oskarvh/wasp/hardware/wasp_node_board/wasp_node_board.kicad_pcb

## KiCad design hardware/wasp_node_board/wasp_node_board.kicad_pcb (2026-09-20)

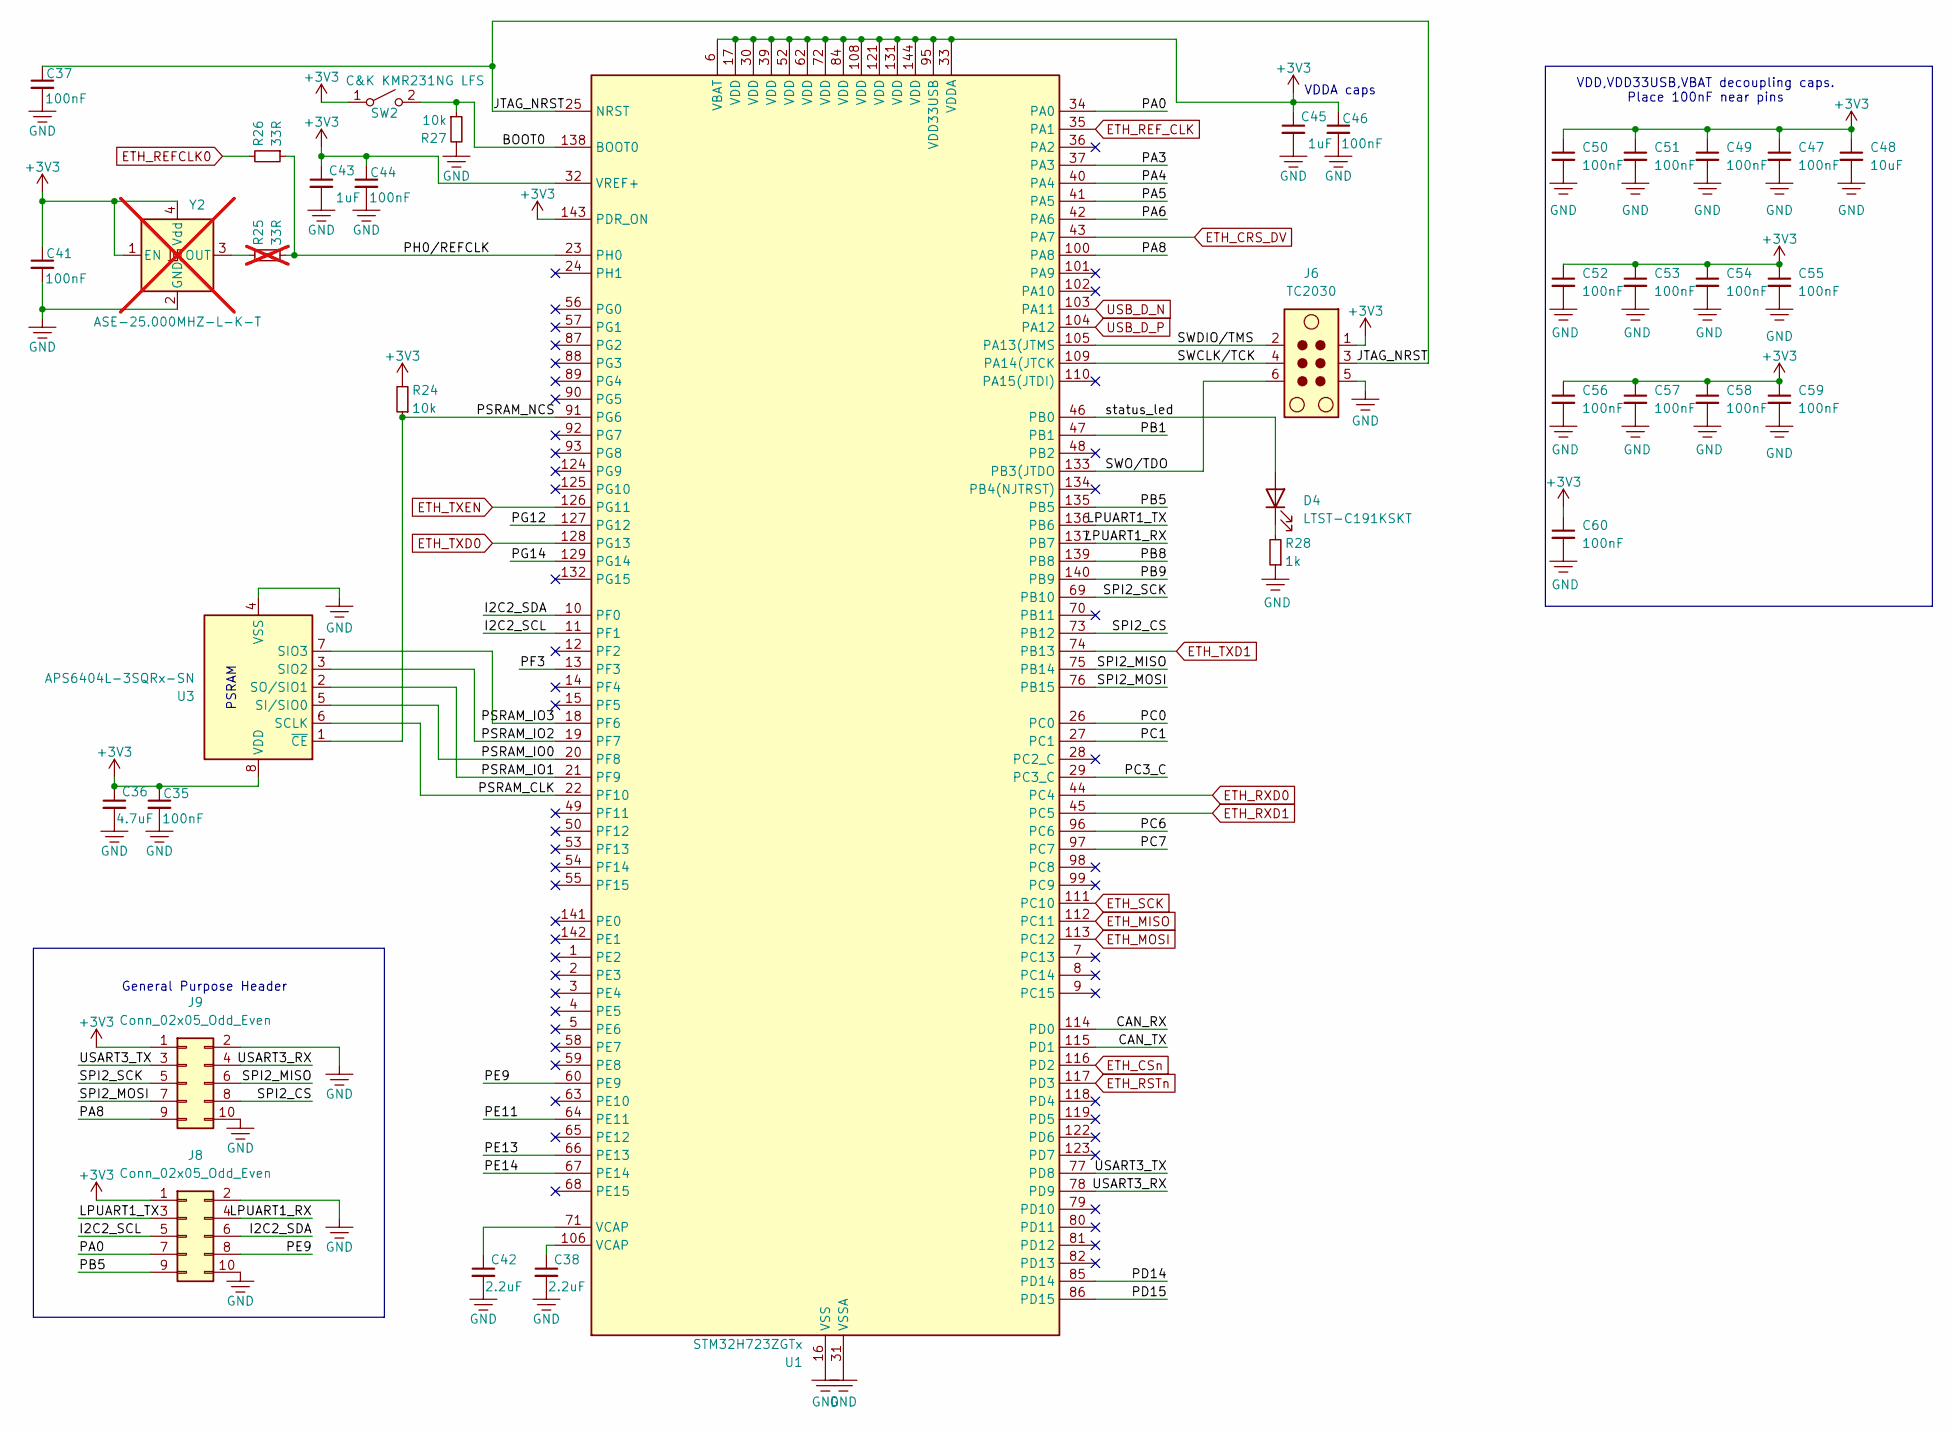
[picture p5: schematic mcu.kicad_sch]

Parts:
C35, C37, C41, C44, C46: 100nF; C_0402_1005Metric
C36: 4.7uF; C_0603_1608Metric
C38, C42: 2.2uF; C_0603_1608Metric
C43, C45: 1uF; C_0603_1608Metric
C47, C49, C50, C51, C52, C53, C54, C55, C56, C57, C58, C59, C60: 100nF; C_0402_1005Metric; LCSC C1525
C48: 10uF; C_0805_2012Metric; LCSC C15850
D4: LTST-C191KSKT; LED_0603_1608Metric
J6: TC2030; Tag-Connect_TC2030-IDC-NL_2x03_P1.27mm_Vertical
J8, J9: Conn_02x05_Odd_Even; PinHeader_2x05_P2.54mm_Vertical_SMD
R24, R27: 10k; R_0402_1005Metric; LCSC C140214
R25: 33R; R_0402_1005Metric; LCSC C140214; not fitted
R26: 33R; R_0402_1005Metric; LCSC C140214
R28: 1k; R_0402_1005Metric; LCSC C140214
SW2: C&K KMR231NG LFS; SW_Push_1P1T_NO_CK_KMR2
U1: STM32H723ZGTx; LQFP-144_20x20mm_P0.5mm
U3: APS6404L-3SQRx-SN; SOIC-8_3.9x4.9mm_P1.27mm
Y2: ASE-25.000MHZ-L-K-T; Oscillator_SMD_Abracon_ASE-4Pin_3.2x2.5mm; not fitted

Connections:
+3V3: C35.1, C36.1, C41.1, C43.1, C44.1, C45.1, C46.1, C47.1, C48.1, C49.1, C50.1, C51.1, C52.1, C53.1, C54.1, C55.1, C56.1, C57.1, C58.1, C59.1, C60.1, J6.1, J8.1, J9.1, R24.2, SW2.1 (A), U1.6 (VBAT), U1.17 (VDD), U1.30 (VDD), U1.32 (VREF+), U1.33 (VDDA), U1.39 (VDD), U1.52 (VDD), U1.62 (VDD), U1.72 (VDD), U1.84 (VDD), U1.95 (VDD33USB), U1.108 (VDD), U1.121 (VDD), U1.131 (VDD), U1.143 (PDR_ON), U1.144 (VDD), U3.8 (VDD), Y2.1 (EN), Y2.4 (Vdd); also elsewhere on the board
/mcu/BOOT0: R27.1, SW2.2 (B), U1.138 (BOOT0)
/mcu/CAN_RX: U1.114 (PD0)
/mcu/CAN_TX: U1.115 (PD1)
/mcu/I2C2_SCL: J8.5, U1.11 (PF1)
/mcu/I2C2_SDA: J8.6, U1.10 (PF0)
/mcu/JTAG_NRST: C37.1, J6.3, U1.25 (NRST)
/mcu/LPUART1_RX: J8.4, U1.137 (PB7)
/mcu/LPUART1_TX: J8.3, U1.136 (PB6)
/mcu/PA0: J8.7, U1.34 (PA0)
/mcu/PA3: U1.37 (PA3)
/mcu/PA4: U1.40 (PA4)
/mcu/PA5: U1.41 (PA5)
/mcu/PA6: U1.42 (PA6)
/mcu/PA8: J9.9, U1.100 (PA8)
/mcu/PB1: U1.47 (PB1)
/mcu/PB5: J8.9, U1.135 (PB5)
/mcu/PB8: U1.139 (PB8)
/mcu/PB9: U1.140 (PB9)
/mcu/PC0: U1.26 (PC0)
/mcu/PC1: U1.27 (PC1)
/mcu/PC3_C: U1.29 (PC3_C)
/mcu/PC6: U1.96 (PC6)
/mcu/PC7: U1.97 (PC7)
/mcu/PD14: U1.85 (PD14)
/mcu/PD15: U1.86 (PD15)
/mcu/PE9: J8.8, U1.60 (PE9)
/mcu/PE11: U1.64 (PE11)
/mcu/PE13: U1.66 (PE13)
/mcu/PE14: U1.67 (PE14)
/mcu/PF3: U1.13 (PF3)
/mcu/PG12: U1.127 (PG12)
/mcu/PG14: U1.129 (PG14)
/mcu/PH0/REFCLK: R25.1, R26.1, U1.23 (PH0)
/mcu/PSRAM_CLK: U1.22 (PF10), U3.6 (SCLK)
/mcu/PSRAM_IO0: U1.20 (PF8), U3.5 (SI/SIO0)
/mcu/PSRAM_IO1: U1.21 (PF9), U3.2 (SO/SIO1)
/mcu/PSRAM_IO2: U1.19 (PF7), U3.3 (SIO2)
/mcu/PSRAM_IO3: U1.18 (PF6), U3.7 (SIO3)
/mcu/PSRAM_NCS: R24.1, U1.91 (PG6), U3.1 (~CE)
/mcu/SPI2_CS: J9.8, U1.73 (PB12)
/mcu/SPI2_MISO: J9.6, U1.75 (PB14)
/mcu/SPI2_MOSI: J9.7, U1.76 (PB15)
/mcu/SPI2_SCK: J9.5, U1.69 (PB10)
/mcu/SWCLK/TCK: J6.4, U1.109 (PA14(JTCK)
/mcu/SWDIO/TMS: J6.2, U1.105 (PA13(JTMS)
/mcu/SWO/TDO: J6.6, U1.133 (PB3(JTDO)
/mcu/USART3_RX: J9.4, U1.78 (PD9)
/mcu/USART3_TX: J9.3, U1.77 (PD8)
/mcu/status_led: D4.2 (A), U1.46 (PB0)
ETH_CRS_DV: U1.43 (PA7); also elsewhere on the board
ETH_CSn: U1.116 (PD2); also elsewhere on the board
ETH_MISO: U1.112 (PC11); also elsewhere on the board
ETH_MOSI: U1.113 (PC12); also elsewhere on the board
ETH_REFCLK0: R26.2; also elsewhere on the board
ETH_REF_CLK: U1.35 (PA1); also elsewhere on the board
ETH_RSTn: U1.117 (PD3); also elsewhere on the board
ETH_RXD0: U1.44 (PC4); also elsewhere on the board
ETH_RXD1: U1.45 (PC5); also elsewhere on the board
ETH_SCK: U1.111 (PC10); also elsewhere on the board
ETH_TXD0: U1.128 (PG13); also elsewhere on the board
ETH_TXD1: U1.74 (PB13); also elsewhere on the board
ETH_TXEN: U1.126 (PG11); also elsewhere on the board
GND: C35.2, C36.2, C37.2, C38.2, C41.2, C42.2, C43.2, C44.2, C45.2, C46.2, C47.2, C48.2, C49.2, C50.2, C51.2, C52.2, C53.2, C54.2, C55.2, C56.2, C57.2, C58.2, C59.2, C60.2, J6.5, J8.2, J8.10, J9.2, J9.10, R27.2, R28.1, U1.16 (VSS), U1.31 (VSSA), U1.38 (VSS), U1.51 (VSS), U1.61 (VSS), U1.83 (VSS), U1.94 (VSS), U1.107 (VSS), U1.120 (VSS), U1.130 (VSS), U3.4 (VSS), Y2.2 (GND); also elsewhere on the board
unnamed: C38.1, U1.106 (VCAP)
unnamed: C42.1, U1.71 (VCAP)
unnamed: D4.1 (K), R28.2
unnamed: R25.2, Y2.3 (OUT)
USB_D_N: U1.103 (PA11); also elsewhere on the board
USB_D_P: U1.104 (PA12); also elsewhere on the board

Notes on the sheet:
General Purpose Header
PSRAM
VDD,VDD33USB,VBAT decoupling caps. Place 100nF near pins
VDDA caps

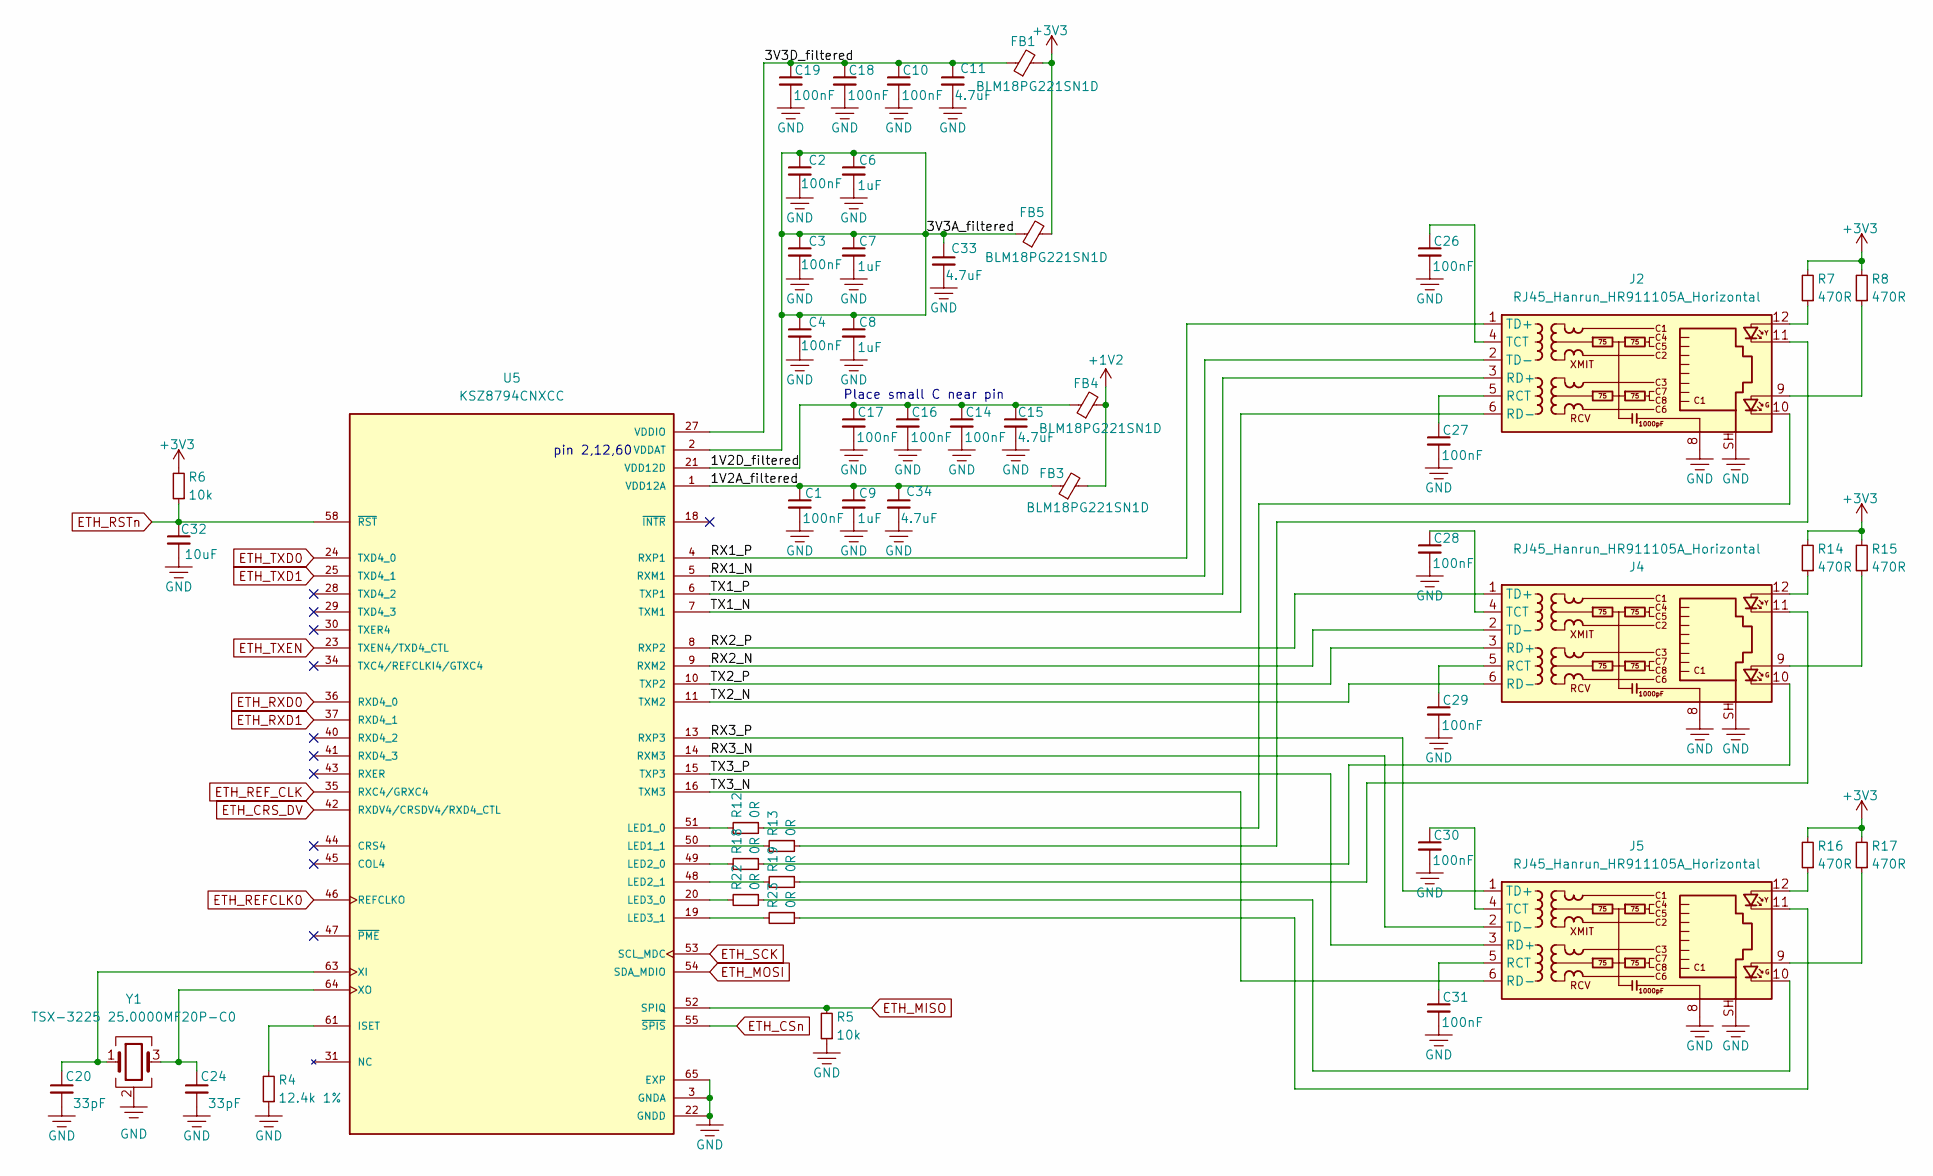
[picture p6: schematic eth.kicad_sch]

Parts:
C1, C2, C3, C4, C10, C14, C16, C17, C18, C19, C26, C27, C28, C29, C30, C31: 100nF; C_0402_1005Metric
C6, C7, C8, C9: 1uF; C_0603_1608Metric
C11, C15, C33, C34: 4.7uF; C_0603_1608Metric
C20, C24: 33pF; C_0402_1005Metric
C32: 10uF; C_0603_1608Metric
FB1, FB3, FB4, FB5: BLM18PG221SN1D; L_0603_1608Metric
J2, J4, J5: RJ45_Hanrun_HR911105A_Horizontal
R4: 12.4k 1%; R_0402_1005Metric; LCSC C140214
R5, R6: 10k; R_0402_1005Metric; LCSC C140214
R7, R8, R14, R15, R16, R17: 470R; R_0402_1005Metric; LCSC C140214
R12, R13, R18, R19, R22, R23: 0R; R_0402_1005Metric; LCSC C140214
U5: KSZ8794CNXCC; IC_KSZ8794CNXCC; PARTREV DS00002134E
Y1: TSX-3225 25.0000MF20P-C0; Crystal_SMD_3225-4Pin_3.2x2.5mm_HandSoldering

Connections:
+1V2: FB3.2, FB4.2; also elsewhere on the board
+3V3: FB1.2, FB5.2, R6.2, R7.2, R8.2, R14.2, R15.2, R16.2, R17.2; also elsewhere on the board
/ethernet/1V2A_filtered: C1.1, C9.1, C34.1, FB3.1, U5.1 (VDD12A)
/ethernet/RX1_N: J2.2 (TD-), U5.5 (RXM1)
/ethernet/RX1_P: J2.1 (TD+), U5.4 (RXP1)
/ethernet/RX2_N: J4.2 (TD-), U5.9 (RXM2)
/ethernet/RX2_P: J4.1 (TD+), U5.8 (RXP2)
/ethernet/RX3_N: J5.2 (TD-), U5.14 (RXM3)
/ethernet/RX3_P: J5.1 (TD+), U5.13 (RXP3)
/ethernet/TX1_N: J2.6 (RD-), U5.7 (TXM1)
/ethernet/TX1_P: J2.3 (RD+), U5.6 (TXP1)
/ethernet/TX2_N: J4.6 (RD-), U5.11 (TXM2)
/ethernet/TX2_P: J4.3 (RD+), U5.10 (TXP2)
/ethernet/TX3_N: J5.6 (RD-), U5.16 (TXM3)
/ethernet/TX3_P: J5.3 (RD+), U5.15 (TXP3)
ETH_CRS_DV: U5.42 (RXDV4/CRSDV4/RXD4_CTL); also elsewhere on the board
ETH_CSn: U5.55 (~SPIS); also elsewhere on the board
ETH_MISO: R5.2, U5.52 (SPIQ); also elsewhere on the board
ETH_MOSI: U5.54 (SDA_MDIO); also elsewhere on the board
ETH_REFCLK0: U5.46 (REFCLKO); also elsewhere on the board
ETH_REF_CLK: U5.35 (RXC4/GRXC4); also elsewhere on the board
ETH_RSTn: C32.1, R6.1, U5.58 (~RST); also elsewhere on the board
ETH_RXD0: U5.36 (RXD4_0); also elsewhere on the board
ETH_RXD1: U5.37 (RXD4_1); also elsewhere on the board
ETH_SCK: U5.53 (SCL_MDC); also elsewhere on the board
ETH_TXD0: U5.24 (TXD4_0); also elsewhere on the board
ETH_TXD1: U5.25 (TXD4_1); also elsewhere on the board
ETH_TXEN: U5.23 (TXEN4/TXD4_CTL); also elsewhere on the board
GND: C1.2, C2.2, C3.2, C4.2, C6.2, C7.2, C8.2, C9.2, C10.2, C11.2, C14.2, C15.2, C16.2, C17.2, C18.2, C19.2, C20.2, C24.2, C26.2, C27.2, C28.2, C29.2, C30.2, C31.2, C32.2, C33.2, C34.2, J2.8, J2.SH, J4.8, J4.SH, J5.8, J5.SH, R4.1, R5.1, U5.3 (GNDA), U5.17 (GNDA), U5.22 (GNDD), U5.26 (GNDD), U5.32 (GNDD), U5.38 (GNDD), U5.57 (GNDD), U5.62 (GNDA), U5.65 (EXP), Y1.2 (G), Y1.4 (G); also elsewhere on the board
unnamed: J2.9, R8.1
unnamed: J2.10, R12.1
unnamed: J2.11, R13.1
unnamed: J2.12, R7.1
unnamed: C27.1, J2.5 (RCT)
unnamed: C26.1, J2.4 (TCT)
unnamed: J4.9, R15.1
unnamed: J4.10, R18.1
unnamed: J4.11, R19.1
unnamed: J4.12, R14.1
unnamed: C29.1, J4.5 (RCT)
unnamed: C28.1, J4.4 (TCT)
unnamed: J5.9, R17.1
unnamed: J5.10, R22.1
unnamed: J5.11, R23.1
unnamed: J5.12, R16.1
unnamed: C31.1, J5.5 (RCT)
unnamed: C30.1, J5.4 (TCT)
unnamed: R4.2, U5.61 (ISET)
unnamed: R12.2, U5.51 (LED1_0)
unnamed: R13.2, U5.50 (LED1_1)
unnamed: R18.2, U5.49 (LED2_0)
unnamed: R19.2, U5.48 (LED2_1)
unnamed: R22.2, U5.20 (LED3_0)
unnamed: R23.2, U5.19 (LED3_1)
unnamed: C20.1, U5.63 (XI), Y1.1
unnamed: C24.1, U5.64 (XO), Y1.3
VDD12D: C14.1, C15.1, C16.1, C17.1, FB4.1, U5.21 (VDD12D), U5.33 (VDD12D), U5.59 (VDD12D)
VDDAT: C2.1, C3.1, C4.1, C6.1, C7.1, C8.1, C33.1, FB5.1, U5.2 (VDDAT), U5.12 (VDDAT), U5.60 (VDDAT)
VDDIO: C10.1, C11.1, C18.1, C19.1, FB1.1, U5.27 (VDDIO), U5.39 (VDDIO), U5.56 (VDDIO)

Notes on the sheet:
pin 2,12,60
Place small C near pin

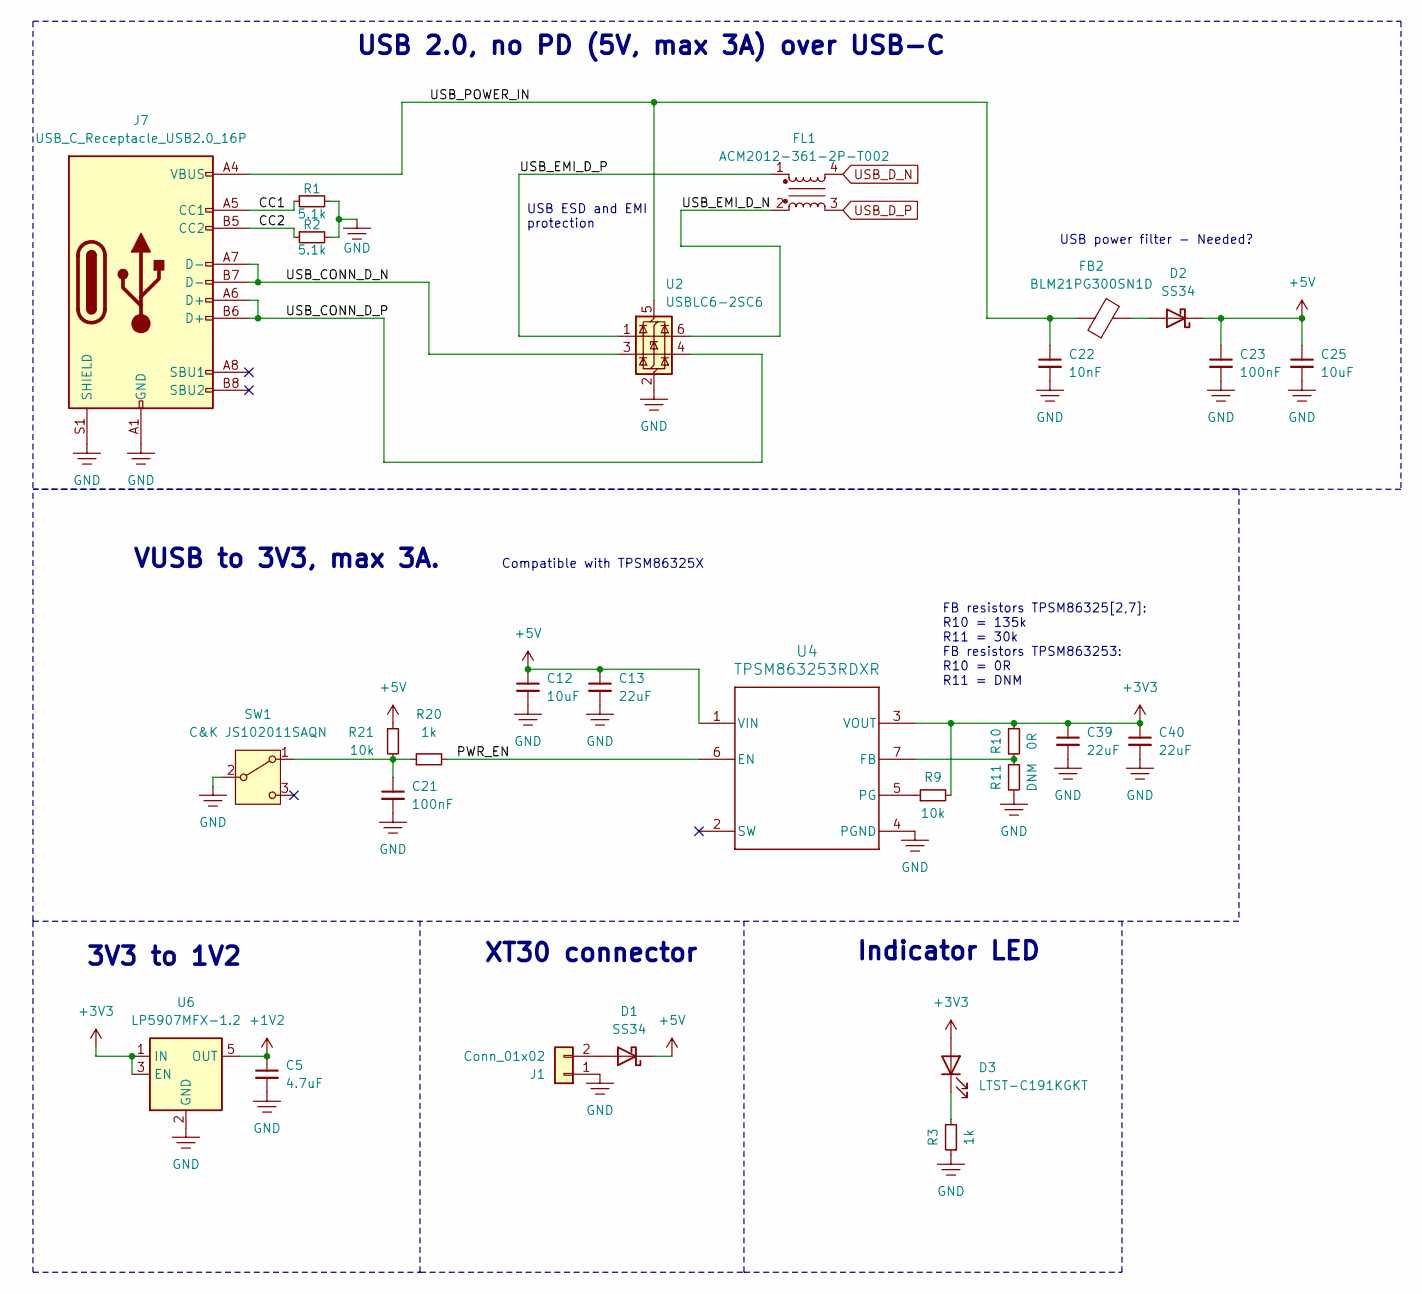
[picture p7: schematic power.kicad_sch]

Parts:
C5: 4.7uF; C_0603_1608Metric
C12, C25: 10uF; C_0805_2012Metric; LCSC C15850
C13, C39, C40: 22uF; C_0805_2012Metric; LCSC C45783
C21, C23: 100nF; C_0402_1005Metric; LCSC C1525
C22: 10nF; C_0402_1005Metric; LCSC C15195
D1, D2: SS34; D_SMA
D3: LTST-C191KGKT; LED_0603_1608Metric
FB2: BLM21PG300SN1D; R_0805_2012Metric; LCSC C16903
FL1: ACM2012-361-2P-T002; ACM2012_TDK
J1: Conn_01x02; AMASS_XT30U-F_1x02_P5.0mm_Vertical
J7: USB_C_Receptacle_USB2.0_16P; USB_C_Receptacle_GCT_USB4110
R1, R2: 5.1k; R_0402_1005Metric; LCSC C258132
R3: 1k; R_0402_1005Metric; LCSC C140214
R9, R21: 10k; R_0402_1005Metric; LCSC C140214
R10: 0R; R_0402_1005Metric; LCSC C279984
R11: DNM; R_0402_1005Metric; LCSC C279984
R20: 1k; R_0402_1005Metric; LCSC C279981
SW1: C&K JS102011SAQN; SW_SPDT_CK_JS102011SAQN
U2: USBLC6-2SC6; SOT-23-6; LCSC C5250994
U4: TPSM863253RDXR; RDX0007A-MFG
U6: LP5907MFX-1.2; SOT-23-5

Connections:
+1V2: C5.1, U6.5 (OUT); also elsewhere on the board
+3V3: C39.1, C40.1, D3.2 (A), R9.2, R10.2, U4.3 (VOUT), U6.1 (IN), U6.3 (EN); also elsewhere on the board
+5V: C12.1, C13.1, C23.1, C25.1, D1.1 (K), D2.1 (K), R21.1, U4.1 (VIN)
/power/CC1: J7.A5 (CC1), R1.1
/power/CC2: J7.B5 (CC2), R2.1
/power/PWR_EN: R20.2, U4.6 (EN)
/power/USB_CONN_D_N: J7.A7 (D-), J7.B7 (D-), U2.3 (I/O2)
/power/USB_CONN_D_P: J7.A6 (D+), J7.B6 (D+), U2.4 (I/O2)
/power/USB_EMI_D_N: FL1.2, U2.6 (I/O1)
/power/USB_EMI_D_P: FL1.1, U2.1 (I/O1)
/power/USB_POWER_IN: C22.1, FB2.1, J7.A4 (VBUS), J7.A9 (VBUS), J7.B4 (VBUS), J7.B9 (VBUS), U2.5 (VBUS)
GND: C5.2, C12.2, C13.2, C21.2, C22.2, C23.2, C25.2, C39.2, C40.2, J1.1, J7.A1 (GND), J7.A12 (GND), J7.B1 (GND), J7.B12 (GND), J7.S1 (SHIELD), R1.2, R2.2, R3.1, R11.1, SW1.2 (B), U2.2 (GND), U4.4 (PGND), U6.2 (GND); also elsewhere on the board
unnamed: D1.2 (A), J1.2
unnamed: D2.2 (A), FB2.2
unnamed: D3.1 (K), R3.2
unnamed: C21.1, R20.1, R21.2, SW1.1 (A)
unnamed: R10.1, R11.2, U4.7 (FB)
unnamed: R9.1, U4.5 (PG)
USB_D_N: FL1.4; also elsewhere on the board
USB_D_P: FL1.3; also elsewhere on the board

Notes on the sheet:
XT30 connector
Compatible with TPSM86325X
FB resistors TPSM86325[2,7]: R10 = 135k R11 = 30k FB resistors TPSM863253: R10 = 0R R11 = DNM
Indicator LED
3V3 to 1V2
USB ESD and EMI protection
USB 2.0, no PD (5V, max 3A) over USB-C
USB power filter - Needed?
VUSB to 3V3, max 3A.

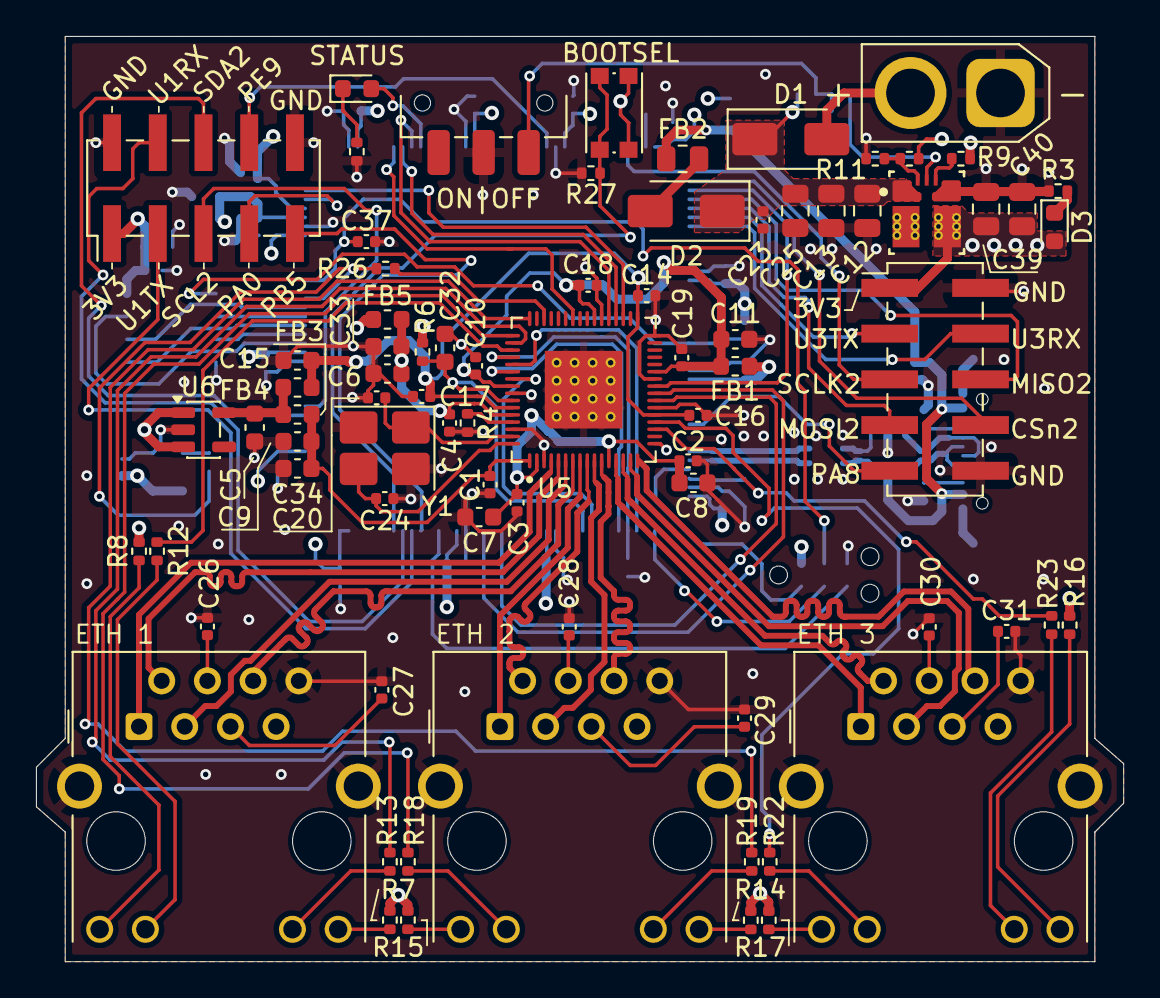
[picture p8: board wasp_node_board.kicad_pcb from above]

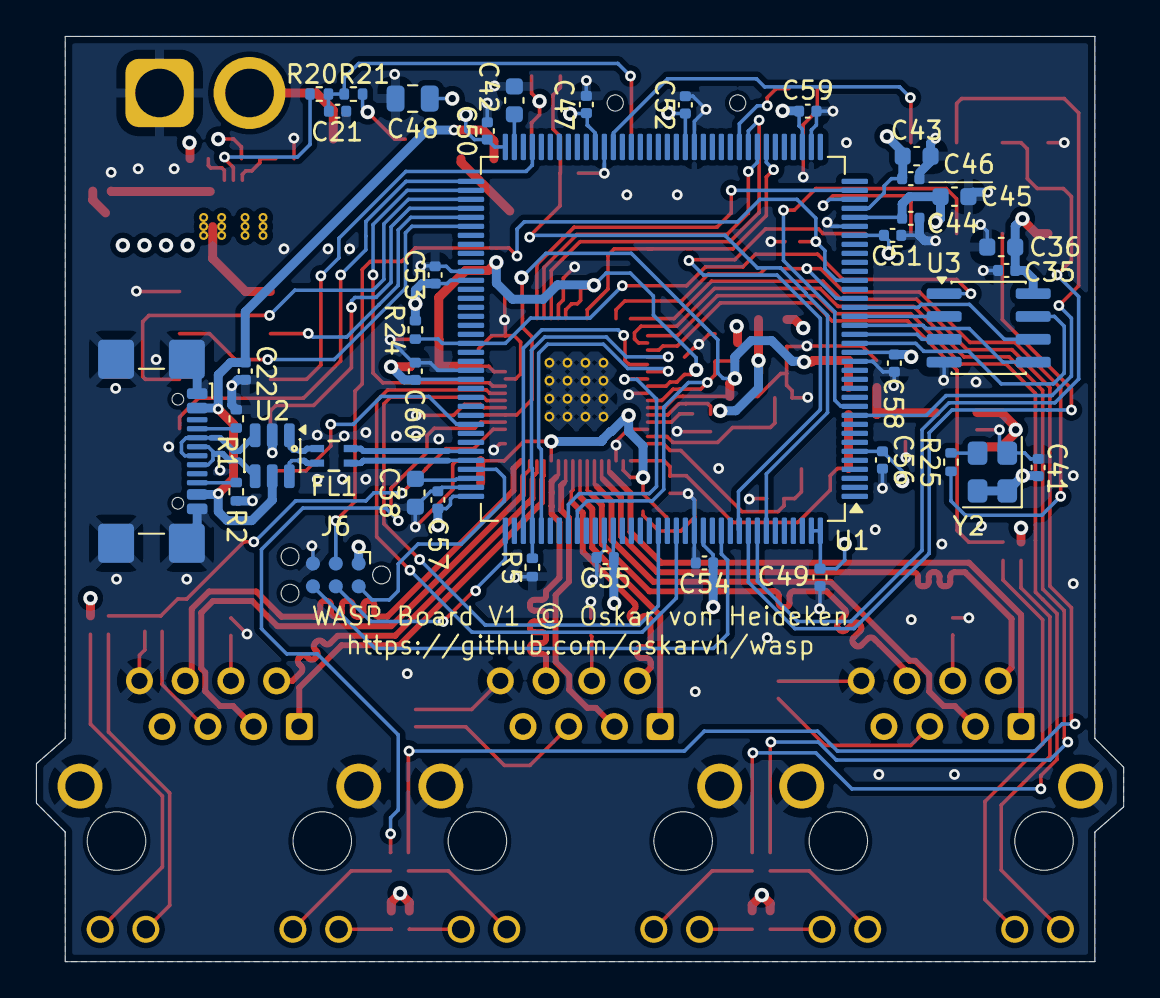
[picture p9: board wasp_node_board.kicad_pcb from below]

Board: 4 copper layers, 60.4 x 51.4 mm, 116 parts (39 on the bottom side), 107 nets.
