oskarvh/wasp/app/src/net/net_thread.c

/*
 * Network handler thread.
 *
 * Owns the network interface and the coordinator-facing TCP socket
 * exclusively. Brings the interface up (DHCP), then serves one
 * coordinator connection at a time: complete frames from the wire go to
 * wasp_rx_q, responses from wasp_tx_q go back onto the wire.
 *
 * Framing errors are handled here, before the agent ever sees the
 * message: an unknown magic means the stream is desynchronized and the
 * connection is dropped; oversized or unallocatable payloads are drained
 * from the stream and answered with an ERROR frame directly.
 */
#include <string.h>

#include <zephyr/kernel.h>
#include <zephyr/logging/log.h>
#include <zephyr/net/socket.h>
#include <zephyr/sys/byteorder.h>

#include "led.h"
#include "netup.h"
#include "wasp.h"

LOG_MODULE_REGISTER(wasp_net, LOG_LEVEL_INF);

atomic_t wasp_node_busy;

/* How often the serve loop wakes to drain wasp_tx_q while idle. This
 * bounds the latency of every node-initiated RPC (remote memory): the
 * request sits in wasp_tx_q until the poll wakes. 50 ms here made the
 * TX wait — not the network — the dominant cost of remote memory
 * (measured: ~45 of 46 s in a 6-node locked-increment run). */
#define SERVE_POLL_MS 2

/* A peer that stalls mid-frame longer than this is dropped, so a broken
 * coordinator cannot wedge the node's single connection slot. */
#define SOCK_TIMEOUT_SECONDS 10

/* Bumped on every accept; rx messages are stamped with it and tx
 * messages carrying a stale generation are discarded unsent. */
static uint8_t conn_gen;

/* --- socket helpers -------------------------------------------------- */

/* Receive exactly len bytes. Returns 0, or -1 on error/peer close. */
static int recv_full(int sock, uint8_t *buf, size_t len)
{
	while (len > 0) {
		ssize_t n = zsock_recv(sock, buf, len, 0);

		if (n <= 0) {
			return -1;
		}
		buf += n;
		len -= n;
	}
	return 0;
}

/* Read and discard len bytes to keep the stream in sync. */
static int drain_bytes(int sock, uint32_t len)
{
	uint8_t scratch[64];

	while (len > 0) {
		size_t chunk = MIN(len, sizeof(scratch));

		if (recv_full(sock, scratch, chunk) < 0) {
			return -1;
		}
		len -= chunk;
	}
	return 0;
}

static int send_full(int sock, const uint8_t *buf, size_t len)
{
	while (len > 0) {
		ssize_t n = zsock_send(sock, buf, len, 0);

		if (n < 0) {
			return -1;
		}
		buf += n;
		len -= n;
	}
	return 0;
}

static int send_frame(int sock, const struct wasp_msg *msg)
{
	uint8_t hdr[WASP_FRAME_HDR_SIZE];

	hdr[WASP_FRAME_OFF_MAGIC] = WASP_PROTO_MAGIC0;
	hdr[WASP_FRAME_OFF_MAGIC + 1] = WASP_PROTO_MAGIC1;
	hdr[WASP_FRAME_OFF_TYPE] = msg->type;
	hdr[WASP_FRAME_OFF_SEQ] = msg->seq;
	sys_put_le32(msg->len, &hdr[WASP_FRAME_OFF_LEN]);

	if (send_full(sock, hdr, sizeof(hdr)) < 0) {
		return -1;
	}
	if (msg->len > 0 && send_full(sock, msg->payload, msg->len) < 0) {
		return -1;
	}
	return 0;
}

static int send_error(int sock, uint8_t seq, uint8_t err)
{
	struct wasp_msg msg = {
		.type = WASP_MSG_ERROR,
		.seq = seq,
		.len = 1,
		.payload = &err,
	};

	return send_frame(sock, &msg);
}

/* --- frame rx/tx ------------------------------------------------------ */

/*
 * Receive one frame and hand it to the agent.
 * Returns 0 on success (including handled-and-skipped frames), -1 when
 * the connection must be closed.
 */
static int recv_frame(int sock)
{
	uint8_t hdr[WASP_FRAME_HDR_SIZE];
	struct wasp_msg msg = {0};
	uint32_t len;

	if (recv_full(sock, hdr, sizeof(hdr)) < 0) {
		return -1;
	}

	if (hdr[WASP_FRAME_OFF_MAGIC] != WASP_PROTO_MAGIC0 ||
	    hdr[WASP_FRAME_OFF_MAGIC + 1] != WASP_PROTO_MAGIC1) {
		LOG_WRN("bad magic %02x%02x, dropping connection", hdr[0], hdr[1]);
		return -1;
	}

	msg.type = hdr[WASP_FRAME_OFF_TYPE];
	msg.seq = hdr[WASP_FRAME_OFF_SEQ];
	msg.conn = conn_gen;
	len = sys_get_le32(&hdr[WASP_FRAME_OFF_LEN]);

	if (len > CONFIG_WASP_MAX_MODULE_SIZE) {
		LOG_WRN("frame type 0x%02x len %u exceeds cap %d", msg.type, len,
			CONFIG_WASP_MAX_MODULE_SIZE);
		if (drain_bytes(sock, len) < 0 ||
		    send_error(sock, msg.seq, WASP_ERR_TOO_LARGE) < 0) {
			return -1;
		}
		return 0;
	}

	if (len > 0) {
		msg.payload = k_heap_alloc(&wasp_payload_heap, len, K_MSEC(500));
		if (msg.payload == NULL) {
			LOG_WRN("no memory for %u byte payload", len);
			if (drain_bytes(sock, len) < 0 ||
			    send_error(sock, msg.seq, WASP_ERR_NO_MEM) < 0) {
				return -1;
			}
			return 0;
		}
		if (recv_full(sock, msg.payload, len) < 0) {
			k_heap_free(&wasp_payload_heap, msg.payload);
			return -1;
		}
		msg.len = len;
	}

	if (k_msgq_put(&wasp_rx_q, &msg, K_MSEC(500)) != 0) {
		LOG_WRN("agent queue full, dropping frame type 0x%02x", msg.type);
		if (msg.payload != NULL) {
			k_heap_free(&wasp_payload_heap, msg.payload);
		}
		return send_error(sock, msg.seq, WASP_ERR_BUSY);
	}

	return 0;
}

/*
 * Send queued responses to the coordinator. Messages stamped with a
 * stale connection generation (produced for a peer that is already
 * gone) are discarded unsent; pass sock < 0 to discard everything.
 * Returns 0, or -1 when the connection must be closed.
 */
static int flush_tx(int sock)
{
	struct wasp_msg msg;
	int rc = 0;

	while (k_msgq_get(&wasp_tx_q, &msg, K_NO_WAIT) == 0) {
		if (msg.conn != conn_gen) {
			LOG_WRN("discarding stale response type 0x%02x (conn %u, now %u)",
				msg.type, msg.conn, conn_gen);
		} else if (sock >= 0 && rc == 0) {
			rc = send_frame(sock, &msg);
		}
		if (msg.payload != NULL) {
			k_heap_free(&wasp_payload_heap, msg.payload);
		}
	}
	return rc;
}

static void serve(int client)
{
	struct zsock_pollfd pfd = {
		.fd = client,
		.events = ZSOCK_POLLIN,
	};

	while (true) {
		int rc = zsock_poll(&pfd, 1, SERVE_POLL_MS);

		if (rc < 0) {
			LOG_ERR("poll() failed: %d", errno);
			return;
		}
		if (pfd.revents & (ZSOCK_POLLHUP | ZSOCK_POLLERR)) {
			return;
		}
		if ((pfd.revents & ZSOCK_POLLIN) && recv_frame(client) < 0) {
			return;
		}
		if (flush_tx(client) < 0) {
			return;
		}
	}
}

static void net_thread_fn(void *a, void *b, void *c)
{
	ARG_UNUSED(a);
	ARG_UNUSED(b);
	ARG_UNUSED(c);

	wasp_net_up();

	int server = zsock_socket(AF_INET, SOCK_STREAM, IPPROTO_TCP);

	if (server < 0) {
		LOG_ERR("socket() failed: %d", errno);
		return;
	}

	struct sockaddr_in bind_addr = {
		.sin_family = AF_INET,
		.sin_addr = {.s_addr = htonl(INADDR_ANY)},
		.sin_port = htons(CONFIG_WASP_AGENT_PORT),
	};

	if (zsock_bind(server, (struct sockaddr *)&bind_addr, sizeof(bind_addr)) < 0 ||
	    zsock_listen(server, 1) < 0) {
		LOG_ERR("bind/listen failed: %d", errno);
		zsock_close(server);
		return;
	}

	LOG_INF("listening for coordinator on port %d", CONFIG_WASP_AGENT_PORT);

	while (true) {
		int client = zsock_accept(server, NULL, NULL);

		if (client < 0) {
			LOG_ERR("accept() failed: %d", errno);
			continue;
		}

		conn_gen++;

		struct zsock_timeval timeout = {.tv_sec = SOCK_TIMEOUT_SECONDS};
		int nodelay = 1;

		zsock_setsockopt(client, SOL_SOCKET, SO_RCVTIMEO, &timeout, sizeof(timeout));
		zsock_setsockopt(client, SOL_SOCKET, SO_SNDTIMEO, &timeout, sizeof(timeout));
		/* Frames go out as header + payload (two sends); without
		 * this, Nagle holds the second segment for the peer's
		 * delayed ACK — ~40 ms on every small RPC. */
		zsock_setsockopt(client, IPPROTO_TCP, TCP_NODELAY, &nodelay, sizeof(nodelay));

		atomic_set(&wasp_node_busy, 1);
		wasp_led_set(WASP_LED_CONNECTED);

		LOG_INF("coordinator connected");
		serve(client);
		zsock_close(client);
		flush_tx(-1);
		LOG_INF("coordinator disconnected");

		atomic_set(&wasp_node_busy, 0);
		wasp_led_set(WASP_LED_READY);
	}
}

K_THREAD_DEFINE(wasp_net_tid, CONFIG_WASP_NET_THREAD_STACK_SIZE, net_thread_fn, NULL, NULL, NULL,
		K_PRIO_PREEMPT(6), 0, 0);
