oskarvh/wasp/(commit log)

2026-07-11 Wire protocol created and tested
2026-07-13 added rpi pico w support, and tested for regressions
2026-07-13 Added discovery mode, LED indications and other quality of life improvements
2026-07-14 Removed powersave on the pico's wifi chip, it messes with the LED. Also, added a note regarding future unicasting
2026-07-14 Implemented atomic RPC primitives to speed things up, and reduced some latency related TCP issues
    [net_thread.c, protocol.h]
2026-07-19 Added libwasp — the coordinator is now a C library — plus design docs
    libwasp/ implements the full coordinator role in C (framing, blocking
    RPC with inline remote-memory serving, region/lock/atomics engine with
    queued locks and lease expiry, UDP discovery, write-observation
    events), with a scripted-fake-node test (make check, no hardware) and
    a zero-dependency ctypes binding (tools/libwasp.py) exposing a
    wasp_client-compatible WaspNode. wasp_client's unchanged self-test
    suites pass through the C library on both board types
    (tools/libwasp_selftest.py), and the Mandelbrot demo now runs on it —
    same 4 s render, chaos re-issue and GIF recording included.
    Also parked two design docs: docs/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
2026-07-19 Ported libwasp into Zephyr firmware — nodes can now coordinate each other
    libwasp core is OS-free and allocation-free behind a small port layer
    (port_posix.c / port_zephyr.c); CONFIG_WASP_PEER compiles the engine
    into the app (~7 KiB RAM), and CONFIG_WASP_PEER_SMOKE adds a boot-time
    test where the Nucleo dials a stock-firmware Pico, pushes the remote
    memory module from its own flash, and serves the module's region/lock
    RPCs from its own RAM. Verified on hardware: PEER SMOKE: PASS, with
    the POSIX side (mock test + fleet selftest) regression-free.
2026-08-26 Firmware conductor — a Nucleo discovers 5 Picos and renders the Mandelbrot, no PC
2026-09-13 Started the node board in KiCad — every wasp node is now also a 3-port switch
    Claude-Session: https://claude.ai/code/session_01R5uaLk4w44r9dBy8LCo6if
2026-09-13 Node board schematic complete — MCU, switch, PSRAM, power and expansion
    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
2026-09-14 Schematic verified clean and layout started
    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
2026-09-14 Board setup for OSH Park — FR408 stackup, impedance net classes, DRC rules
    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
2026-09-20 Order of the V1 board done
2026-10-12 Add wasp_node board support and KSZ8794 switch configuration
    The custom node board boots, gets a DHCP lease and passes the protocol,
    lifecycle and remote-memory suites on real hardware.
    Board definition (boards/wasp/wasp_node, HWMv2) is a Nucleo-H723ZG in
    most respects; the three things that differ are each commented where
    they appear in the DTS:
    - The RMII side is wired MAC-to-MAC into the switch, so there is no
    PHY and no MDIO. The link is described as ethernet-phy-fixed-link,
    which is accurate rather than a workaround: it is a PCB trace at
    100M full duplex that cannot go down.
    - HSE is bypass-fed from the switch's REFCLK0, so build 1 runs from
    HSI at 64 MHz to keep t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
2026-10-12 Run the wasp node board from HSE 25 MHz and PLL1 at 550 MHz
    Bring-up deliberately ran on HSI because HSE is bypass-fed from the
    KSZ8794's REFCLKO through R26: enabling it makes the MCU's clock tree
    depend on the switch, and a dead REFCLKO would hang the HSE-ready poll
    inside SystemClock_Config before any application code runs, leaving a
    board that takes SWD but never prints. Ethernet working proved REFCLKO
    good, so the clock tree now moves over.
    PLL1: 25 / 5 = 5 MHz reference, x110 = 550 MHz VCO, /1 = 550 MHz SYSCLK,
    HCLK 275 MHz and the APB buses at 137.5 MHz. PLL1_Q lands at 137.5 MHz,
    which is also the OCTOSPI kernel clock the PSRAM will divide down from.
    main() now logs the clock tree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
2026-10-12 Bring up the VTI7064 quad PSRAM on OCTOSPI1, memory-mapped reads working
    The fitted part is a Vilsion VTI7064MSME, not the APS6404L the board was
    drawn around. Same pinout, package, density and command set; different
    timing, and one difference matters — tCEM is 4 us against the APS6404L's
    8 us. The devicetree therefore declares tCEM in nanoseconds and the driver
    converts it against the clock it actually achieved, instead of carrying the
    precomputed 600-cycle refresh value that was in the DTS and would have been
    twice too long for this part. Overrunning tCEM blocks the internal refresh
    and the array loses data with nothing reported.
    Zephyr's st,stm32-ospi-psram driver turned out to be unus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
2026-10-12 Abandon external PSRAM on v1 and record the V2 octal decision
    Bulk memory-mapped writes to the quad PSRAM do not work and are not
    fixable from the driver. On an AXI-attached OCTOSPI, memory-mapped writes
    go out in multiples of the 64-bit bus width, and the DQSE bit in
    OCTOSPI_WCCR that has to be set to stop writes returning an error
    response also stops AXI byte-enable masking working, so masked lanes get
    written anyway. About one word per 352 bytes reads back as zero across
    the array, while the same addresses pass when written and verified a
    kilobyte at a time. Ruled out first: sampling (identical at 68.75 MHz and
    19.6 MHz), tCEM enforcement and burst chopping (unchanged with the
    refresh cou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
2026-10-12 Size the WAMR pool at boot from whatever RAM is left over
    The pool was a static 90112-byte array, a figure chosen for the F439 and
    then carried onto a board with two thirds more RAM. It is now the span
    from _image_ram_end to __kernel_ram_end: everything left once data, bss,
    noinit, the thread stacks and the kernel heap have been placed. Nothing
    else lives there — all of those are static and therefore already below
    _image_ram_end — and the map confirms the span is empty.
    Measured, from one build each:
    wasp_node (320 KB) static RAM 150904 -> 60792 B, pool 266888 B, ~3 instances
    nucleo_f439zi (192 KB) static RAM 163320 -> 73208 B, pool 123400 B, ~1 instance
    So the per-board number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
2026-10-12 Host several module instances per node, executing concurrently
    Splits module from instance the way WAMR already does internally: a
    module is validated bytecode (wasm_module_t) plus the .wasm buffer the
    interpreter keeps referencing, an instance is an instantiation of one
    (wasm_module_inst_t) with its own linear memory and exec_env. Separating
    them is what lets unrelated programs sit side by side and what gives the
    "same bytecode, several instances" case somewhere to live. Nothing ties a
    node's instances to one program.
    New messages, gated behind WASP_FEAT_MULTI_INSTANCE:
    MODULE_UPLOAD [n_inst][.wasm] -> [mod][n][inst × n]
    INSTANTIATE [mod][count] -> [count][inst × count]
    CALL_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
2026-10-12 Pipeline the client and prove instances run while others block
    The node has had a pool of executor threads since the last commit, but
    nothing demonstrated the property they exist for: that a call parked on a
    remote-memory round trip does not stop another instance running. It was
    unobservable, because a send-and-wait client can never have two calls in
    flight to see it.
    WaspNode gains send()/collect() alongside request(), which is now just
    the two composed. Responses may arrive in any order, so _outstanding
    tracks what is still owed and _pending what has arrived uncollected; a
    response for a seq that was never requested still raises, which keeps the
    stale-stream check the old strict seq compa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
2026-10-12 Teach libwasp the instance API and allow several calls in flight
    The C coordinator spoke only the v1 default-instance path, so none of a
    node's three instances were reachable from it. It now has the whole
    instance API: wasp_upload (with the n_inst count that sends bytecode once
    and returns that many handles), wasp_instantiate, wasp_call_inst,
    wasp_drop_instance, wasp_drop_module and wasp_inventory_get.
    The substantive change is async. The old slot carried a comment
    justifying itself — "one outstanding call per node, the node's executor
    is single-threaded anyway" — which stopped being true when the executor
    became a pool. It is now a table of WASP_MAX_INFLIGHT slots, and
    wasp_call_poll_a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
2026-10-12 Document how to build and flash the wasp node board
    The README listed the Nucleo and the Pico but not the purpose-built
    board, which is now the main target. Adds it to the supported list, the
    build/flash recipe, and a notes section covering the parts that are not
    guessable: that `west flash` uses an ST-Link V2 configuration rather than
    the V3 path the in-tree Nucleo boards use, that `-p` is needed after a
    Kconfig or devicetree change because Kconfig results are cached, where
    the console comes out (J9.3 = PD8, J9.4 = PD9, 115200) given the board has
    no USB-serial bridge of its own, the CDC-ACM alternative, which RJ45 is
    which switch port, and what a healthy boot log looks like.
    Both document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
2026-10-13 Add USB DFU bootloader entry, by button and over the network
    The board already had the hardware for it: SW2 pulls BOOT0 high against
    R27's 10k pull-down, so holding it through a reset runs the H723's ROM
    DFU bootloader with no firmware involvement at all. This adds the other
    way in, so a node on a shelf can be reflashed without anyone reaching for
    the button — mode 1 of REBOOT, which already meant "come up in the USB
    bootloader" for the RP2040, now does the equivalent on STM32H7. The same
    `wasp_client.py <ip> reboot --bootsel` works on either family and the
    coordinator need not know which board it has.
    Jumping straight to the bootloader from a running system would mean
    undoing a 550 MHz P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
2026-10-13 Record the v1 USB data-path erratum and its rework
    USB power works on the v1 board and USB data cannot, which is why the DFU
    bootloader jumps and then returns: there is no host, because the host can
    never see the device. Two independent faults between J7 and the MCU, both
    the same kind of mistake — a part whose pins were assigned as though its
    internal topology were something else. The copper faithfully implements
    the schematic; neither is a layout or fabrication problem.
    U2, the USBLC6-2SC6, has six pins but four nodes: 1 and 6 are both I/O1,
    3 and 4 are both I/O2. It is a shunt protector, so each pair is internally
    one wire. The schematic treats 1/6 as one side of the device and 3/4 as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
2026-10-13 Attribute the v1 USB shorts to U2 rather than to the connector
    The erratum said "D+ is shorted to D- at the connector", which reads as
    though J7 were miswired. It is not: tying A6/B6 together as D+ and A7/B7
    together as D- is exactly what makes a USB-C receptacle work with the
    cable either way up. Both shorts are created by U2 bridging nets that
    should be distinct, and exist only while U2 is fitted. Replaces the
    sentence with the net membership that shows which pads join what, and
    notes that nothing bridges the connector-side nets to the MCU-side ones
    because U2 was meant to be that bridge.
    No change to the diagnosis or the rework.
    Clau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
2026-10-13 Build the WAMR interpreter for speed, for a 1.87x gain
    The mandelbrot demo was underwhelming, and measurement says the
    interpreter is the entire bill. On two node boards, 256x192 at 96
    iterations takes 2.2 s; doubling the iteration count takes it to 4.2 s,
    while doubling the number of remote-memory round trips — half-height
    tiles, same total pixels, twice the MEM_ADD/MEM_WRITE traffic — leaves it
    at 2.1 s. So the workload is compute-bound in the dispatch loop and the
    network is free. One node against two scales 4.1 s to 2.2 s, confirming
    it tracks cores rather than latency.
    The whole image was built -Os, Zephyr's default and the right default for
    everything here except the one hot loop.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
2026-10-13 Stop the demo's progress view quantising its own timing
    plain_view polled the workers with time.sleep(2.0), and the reported
    render time is taken after that loop exits, so every measurement was
    rounded up to a multiple of two seconds. A 0.4 s render and a 1.9 s one
    both printed "2.1s", and the 2.1 s "floor" that looked like a bottleneck
    was the sleep.
    This mattered: it made the demo look compute-bound to the exclusion of
    everything else. Doubling the iteration count appeared to move 2.1 s to
    2.2 s and doubling the remote-memory traffic appeared to be free, which
    together say "compute is everything". Both were just pinned to the same
    quantum.
    With the poll interval separated from the print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
2026-10-13 Use every instance slot in the demo, and fix a wedge it exposed
    The demo asked each node for one worker, so two boards with three slots
    each ran two workers. It now uploads the module once per node with an
    instance count and drives all of them over that node's single
    connection. The work-stealing design needed no changes: MEM_ADD is
    atomic at the coordinator, so the number of claimants was never baked in.
    Measured, 256x192 at 96 iterations, best of three:
    1 node x 1 instance 1.7 s
    1 node x 3 instances 1.4 s 1.21x
    2 nodes x 1 instance 0.9 s
    2 nodes x 3 instances 0.8 s 1.13x
    Modest, and that is the honest shape of it: instances hide the time a
    call spends waiting on a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
2026-10-13 Add per-instance compute-vs-network counters (NOT yet run on hardware)
    There were no node-side metrics at all. perf_test.py measures host wall
    clock, which cannot tell a node computing from a node waiting on the
    wire, so "how much goes into transmission and how much into compute, and
    how long does each instance wait" had no answer.
    The node is the only place that knows, and the structural fact that makes
    it cheap to answer is that an instance's RPC waits happen inside its
    call. Timing both gives the split directly:
    compute = exec_us - rpc_wait_us
    waiting = rpc_wait_us / exec_us
    Per instance, not per node, because instances interleave precisely so one
    computes while another waits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
2026-10-13 Make the stats readable after a run, and read them before teardown
    The counters came back empty after a render, which was the obvious thing
    to try and the one case that did not work. They live on the instance, and
    releasing the module is the last thing any well-behaved client does, so
    the measurements were destroyed by the cleanup.
    Two fixes, because there are two problems.
    Host side, and this one works against the firmware already flashed: the
    demo now reads the counters *before* teardown, behind --stats, having
    zeroed them at the start so the report covers that run alone.
    tools/libwasp.py gains stats() on top of request() rather than a C entry
    point — the parsing is a few little-endian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
2026-10-16 Make the stats table readable at both ends of its range
    A single manual call is a few microseconds and the table printed
    milliseconds to one decimal, so it came out as "0.0m" — which reads as a
    counter that is not working rather than a call that was quick. The
    counters were right: three fib(24) calls measured 13us.
    Durations now pick a unit per value (us, ms, s) and traffic likewise, so
    13us and 583.8ms are both legible in the same column. Adds a per-round-
    trip summary line, which is the number that exposed the coordinator as
    the bottleneck and is tedious to divide by hand. An all-zero "gone" row
    is suppressed: it only means nothing has been dropped yet, and printing
    it invites reading i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
2026-10-16 Document the per-instance metrics in the README
    Adds the stats commands next to the other wasp_client ones, an example of
    the table, and the measurement that matters: rendering the same frame
    with one, two and three instances per node holds compute per node
    constant while the wait per round trip grows roughly linearly with
    concurrent workers, 2.05 to 6.24 to 11.8 ms. That is a serialized server,
    not the wire — the coordinator handles all remote memory behind one
    mutex, and it is the current ceiling rather than the nodes.
    Also documents `reset`, which was undocumented, and explains why there is
    a "gone" row at all: the counters live on the instance, so releasing a
    module would otherwise di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
2026-10-16 Time calls with the 64-bit cycle counter, not the 32-bit one
    A 1920x1080 render reported 329% waiting and zero compute. The cause is
    mine, and it is the hazard I wrote a warning about and then mis-sized:
    k_cycle_get_32 wraps every 7.809 s at 550 MHz, and I justified using it
    on the grounds that "calls here are milliseconds". They are not. A module
    may loop inside a single export, and the mandelbrot module does precisely
    that — one render call walks every tile — so at this resolution one call
    ran 29.6 s. Modulo the wrap that is 6.17 s, which is what came back as
    "6.00s exec", less than the RPC wait legitimately accrued inside it,
    hence a wait percentage over 100 and a compute figure clamp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
2026-10-16 Record where the board and instance plan actually landed
    The roadmap still had multiple instances per node unchecked and the board
    described as a sketch, which is two sessions out of date.
    Checks off the board itself (built, two of them daisy-chained, 550 MHz
    off the switch's REFCLKO), multiple instances per node, and the
    per-instance metrics that were not in the plan at all and are what
    identified the coordinator as the current ceiling. Adds the two items
    that are now the obvious next ones: teaching the conductor the instance
    API, which libwasp already speaks so it is wiring rather than design, and
    lifting the coordinator ceiling by either per-region locks or by batching
    the per-tile round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
