oskarvh/wasp/(notices)

Notices in the files:
hardware/wasp_node_board/wasp_node_board.kicad_pcb:
WASP Board V1 © Oskar von Heideken
